W3PM/A-Simple-AF-Mobile-Portable-WSPR-Beacon-Controller/README.md

# A-Simple-Mobile-Portable-WSPR-Beacon-Controller
GPS controlled audio WSPR source

This project provides a simple means of generating an audio WSPR signal using either an Arduino Nano or Arduino Uno to drive a FT817 or other SSB transmitter for mobile or portable WSPR beaconing.
